chalmers-vera-team/vera-vesc-starter/HW/vera_vesc_starter.kicad_pcb

## KiCad design HW/vera_vesc_starter.kicad_pcb (2026-11-11)

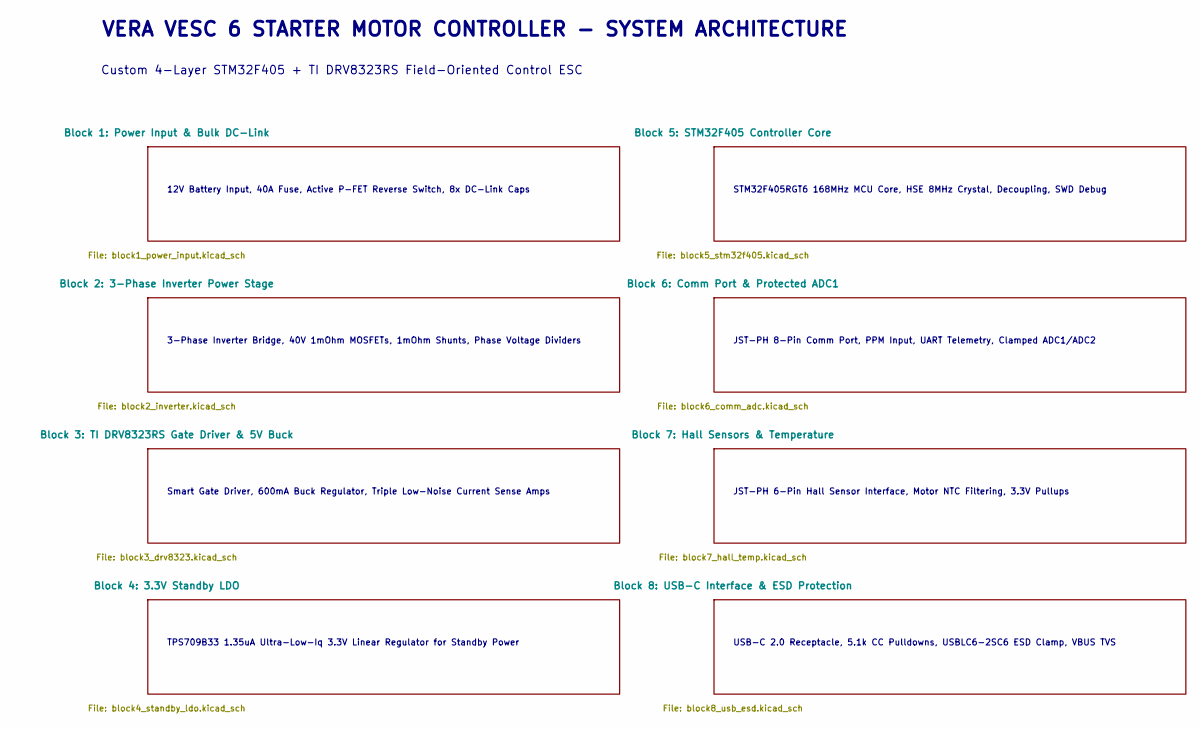
[picture p2: schematic vera_vesc_starter.kicad_sch, Vera VESC 6 Starter Motor Controller]

Notes on the sheet:
Smart Gate Driver, 600mA Buck Regulator, Triple Low-Noise Current Sense Amps
TPS709B33 1.35uA Ultra-Low-Iq 3.3V Linear Regulator for Standby Power
USB-C 2.0 Receptacle, 5.1k CC Pulldowns, USBLC6-2SC6 ESD Clamp, VBUS TVS
STM32F405RGT6 168MHz MCU Core, HSE 8MHz Crystal, Decoupling, SWD Debug
Custom 4-Layer STM32F405 + TI DRV8323RS Field-Oriented Control ESC
3-Phase Inverter Bridge, 40V 1mOhm MOSFETs, 1mOhm Shunts, Phase Voltage Dividers
VERA VESC 6 STARTER MOTOR CONTROLLER - SYSTEM ARCHITECTURE
JST-PH 8-Pin Comm Port, PPM Input, UART Telemetry, Clamped ADC1/ADC2
12V Battery Input, 40A Fuse, Active P-FET Reverse Switch, 8x DC-Link Caps
JST-PH 6-Pin Hall Sensor Interface, Motor NTC Filtering, 3.3V Pullups

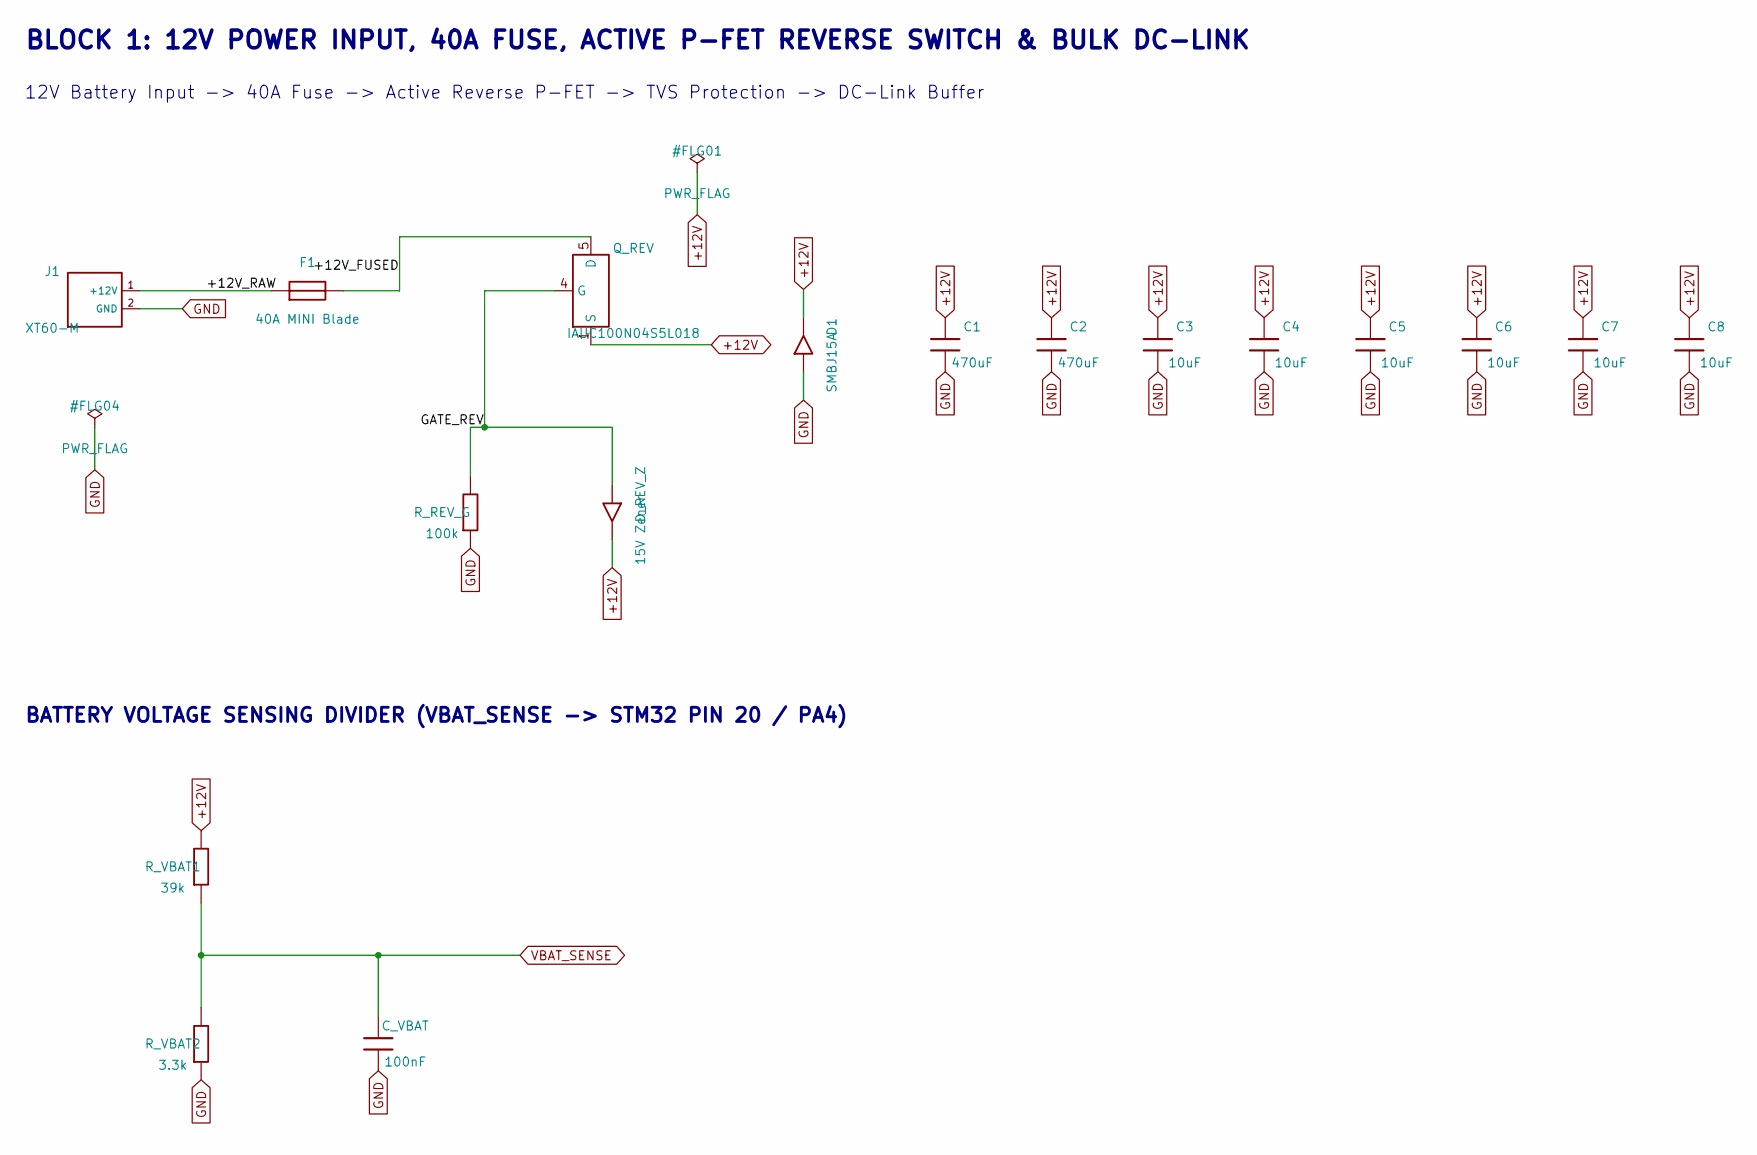
[picture p3: schematic block1_power_input.kicad_sch, Block 1: 12V Power Input & Bulk DC-Link]

Parts:
C1, C2: 470uF; CP_Elec_10x10.5; MPN EEH-ZK1V471P
C3, C4, C5, C6, C7, C8: 10uF; C_1206_3216Metric; MPN C1206C106K5RAC7800
C_VBAT: 100nF; C_0603_1608Metric; MPN CC0603KRX7R9BB104
D1: SMBJ15A; D_SMB; MPN SMBJ15A-E3/52
D_REV_Z: 15V Zener; D_SOD-123; MPN MMSZ5245B
F1: 40A MINI Blade; Fuseholder_Blade_Mini_Keystone_3568; MPN Keystone 3568
J1: XT60-M; AMASS_XT60-M_1x02_P7.20mm_Vertical; MPN AMASS-XT60-M
Q_REV: IAUC100N04S5L018; Infineon_PG-TDSON-8_6.15x5.15mm; MPN IAUC100N04S5L018
R_REV_G: 100k; R_0603_1608Metric; MPN RC0603FR-07100KL
R_VBAT1: 39k; R_0603_1608Metric; MPN RC0603FR-0739KL
R_VBAT2: 3.3k; R_0603_1608Metric; MPN RC0603FR-073K3L

Connections:
+12V: C1.1, C2.1, C3.1, C4.1, C5.1, C6.1, C7.1, C8.1, D1.2 (K), D_REV_Z.2 (K), Q_REV.1 (S), Q_REV.2, Q_REV.3, R_VBAT1.1; also elsewhere on the board
+12V_FUSED: F1.2, Q_REV.5 (D)
+12V_RAW: F1.1, J1.1 (+12V)
GATE_REV: D_REV_Z.1 (A), Q_REV.4 (G), R_REV_G.1
GND: C1.2, C2.2, C3.2, C4.2, C5.2, C6.2, C7.2, C8.2, C_VBAT.2, D1.1 (A), J1.2 (GND), R_REV_G.2, R_VBAT2.2; also elsewhere on the board
VBAT_SENSE: C_VBAT.1, R_VBAT1.2, R_VBAT2.1; also elsewhere on the board

Notes on the sheet:
12V Battery Input -> 40A Fuse -> Active Reverse P-FET -> TVS Protection -> DC-Link Buffer
BATTERY VOLTAGE SENSING DIVIDER (VBAT_SENSE -> STM32 PIN 20 / PA4)
BLOCK 1: 12V POWER INPUT, 40A FUSE, ACTIVE P-FET REVERSE SWITCH & BULK DC-LINK

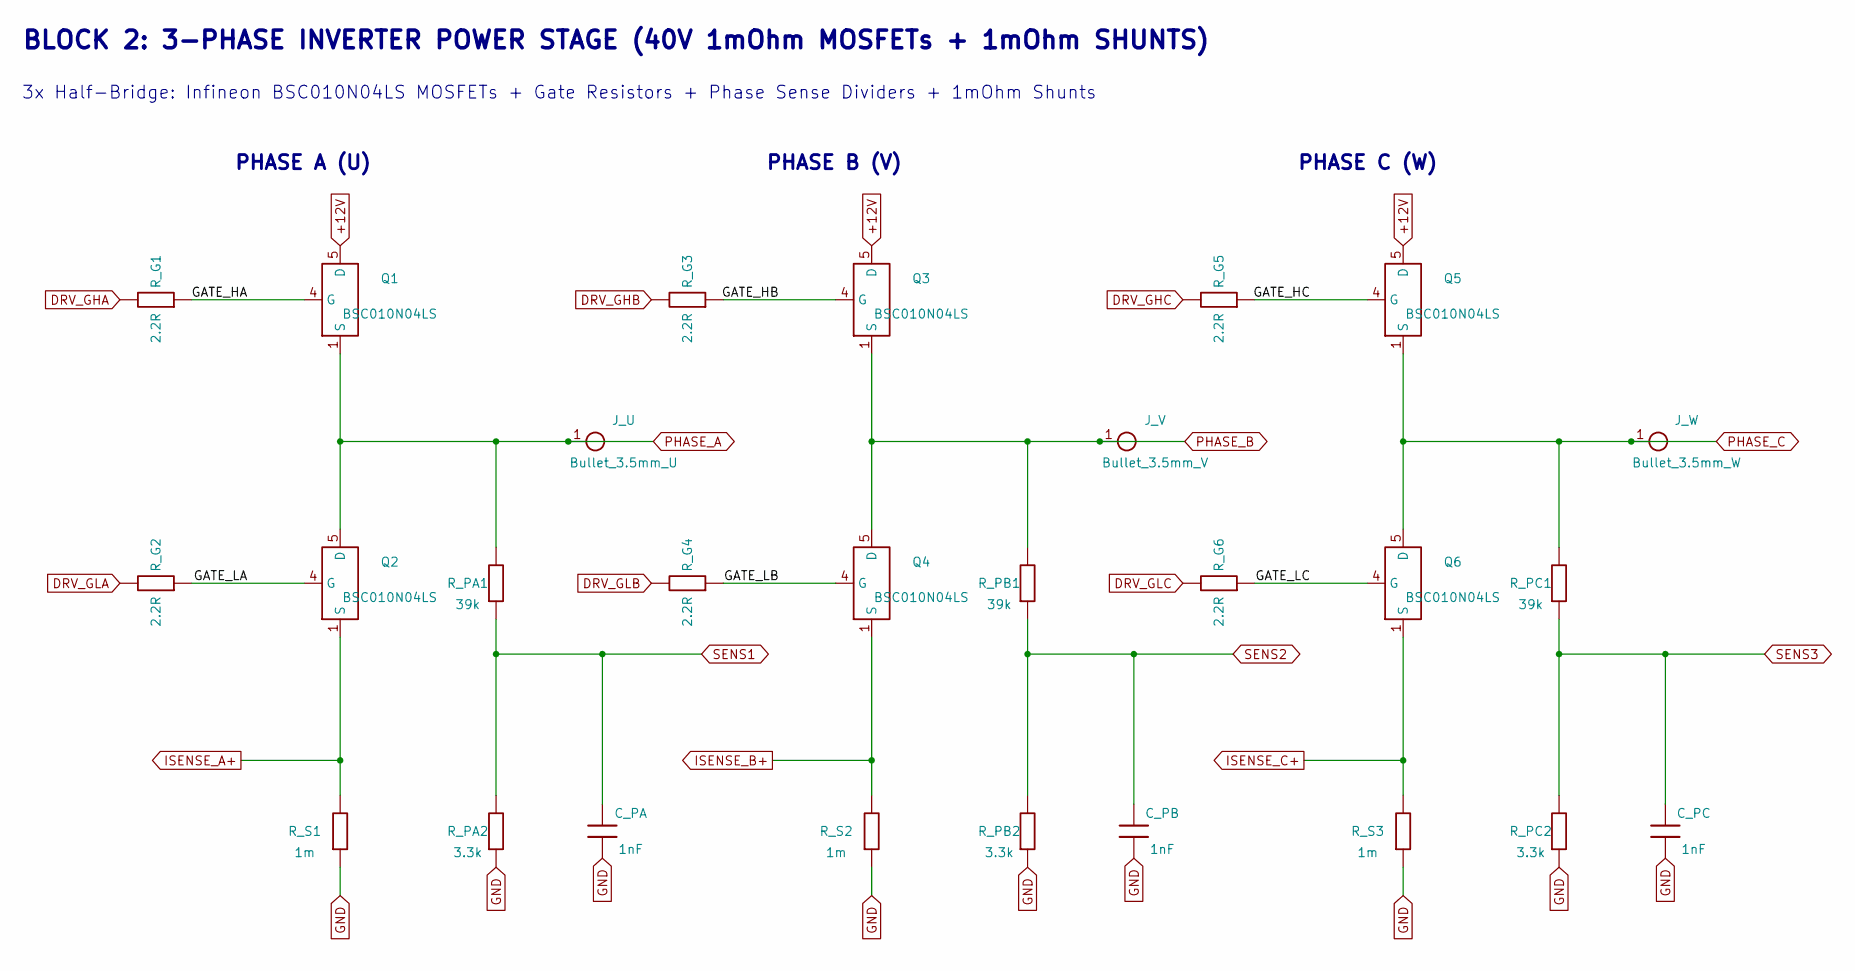
[picture p4: schematic block2_inverter.kicad_sch, Block 2: 3-Phase Inverter Power Stage]

Parts:
C_PA: 1nF; C_0603_1608Metric; MPN CC0603KRX7R9BB102
C_PB: 1nF; C_0603_1608Metric; MPN CC0603KRX7R9BB102
C_PC: 1nF; C_0603_1608Metric; MPN CC0603KRX7R9BB102
J_U: Bullet_3.5mm_U; SolderWire-2.5sqmm_1x01_D2.4mm_OD4.4mm; MPN BULLET-3.5MM-F
J_V: Bullet_3.5mm_V; SolderWire-2.5sqmm_1x01_D2.4mm_OD4.4mm; MPN BULLET-3.5MM-F
J_W: Bullet_3.5mm_W; SolderWire-2.5sqmm_1x01_D2.4mm_OD4.4mm; MPN BULLET-3.5MM-F
Q1, Q2, Q3, Q4, Q5, Q6: BSC010N04LS; Infineon_PG-TDSON-8_6.15x5.15mm; MPN BSC010N04LSATMA1
R_G1, R_G2, R_G3, R_G4, R_G5, R_G6: 2.2R; R_0603_1608Metric; MPN RC0603FR-072R2L
R_PA1: 39k; R_0603_1608Metric; MPN RC0603FR-0739KL
R_PA2: 3.3k; R_0603_1608Metric; MPN RC0603FR-073K3L
R_PB1: 39k; R_0603_1608Metric; MPN RC0603FR-0739KL
R_PB2: 3.3k; R_0603_1608Metric; MPN RC0603FR-073K3L
R_PC1: 39k; R_0603_1608Metric; MPN RC0603FR-0739KL
R_PC2: 3.3k; R_0603_1608Metric; MPN RC0603FR-073K3L
R_S1, R_S2, R_S3: 1m; R_2512_6332Metric; MPN WSLP25121L000FEA

Connections:
+12V: Q1.5 (D), Q3.5 (D), Q5.5 (D); also elsewhere on the board
DRV_GHA: R_G1.1; also elsewhere on the board
DRV_GHB: R_G3.1; also elsewhere on the board
DRV_GHC: R_G5.1; also elsewhere on the board
DRV_GLA: R_G2.1; also elsewhere on the board
DRV_GLB: R_G4.1; also elsewhere on the board
DRV_GLC: R_G6.1; also elsewhere on the board
GATE_HA: Q1.4 (G), R_G1.2
GATE_HB: Q3.4 (G), R_G3.2
GATE_HC: Q5.4 (G), R_G5.2
GATE_LA: Q2.4 (G), R_G2.2
GATE_LB: Q4.4 (G), R_G4.2
GATE_LC: Q6.4 (G), R_G6.2
GND: C_PA.2, C_PB.2, C_PC.2, R_PA2.2, R_PB2.2, R_PC2.2, R_S1.2, R_S2.2, R_S3.2; also elsewhere on the board
ISENSE_A+: Q2.1 (S), Q2.2, Q2.3, R_S1.1; also elsewhere on the board
ISENSE_B+: Q4.1 (S), Q4.2, Q4.3, R_S2.1; also elsewhere on the board
ISENSE_C+: Q6.1 (S), Q6.2, Q6.3, R_S3.1; also elsewhere on the board
PHASE_A: J_U.1, Q1.1 (S), Q1.2, Q1.3, Q2.5 (D), R_PA1.1; also elsewhere on the board
PHASE_B: J_V.1, Q3.1 (S), Q3.2, Q3.3, Q4.5 (D), R_PB1.1; also elsewhere on the board
PHASE_C: J_W.1, Q5.1 (S), Q5.2, Q5.3, Q6.5 (D), R_PC1.1; also elsewhere on the board
SENS1: C_PA.1, R_PA1.2, R_PA2.1; also elsewhere on the board
SENS2: C_PB.1, R_PB1.2, R_PB2.1; also elsewhere on the board
SENS3: C_PC.1, R_PC1.2, R_PC2.1; also elsewhere on the board

Notes on the sheet:
BLOCK 2: 3-PHASE INVERTER POWER STAGE (40V 1mOhm MOSFETs + 1mOhm SHUNTS)
PHASE B (V)
PHASE C (W)
PHASE A (U)
3x Half-Bridge: Infineon BSC010N04LS MOSFETs + Gate Resistors + Phase Sense Dividers + 1mOhm Shunts

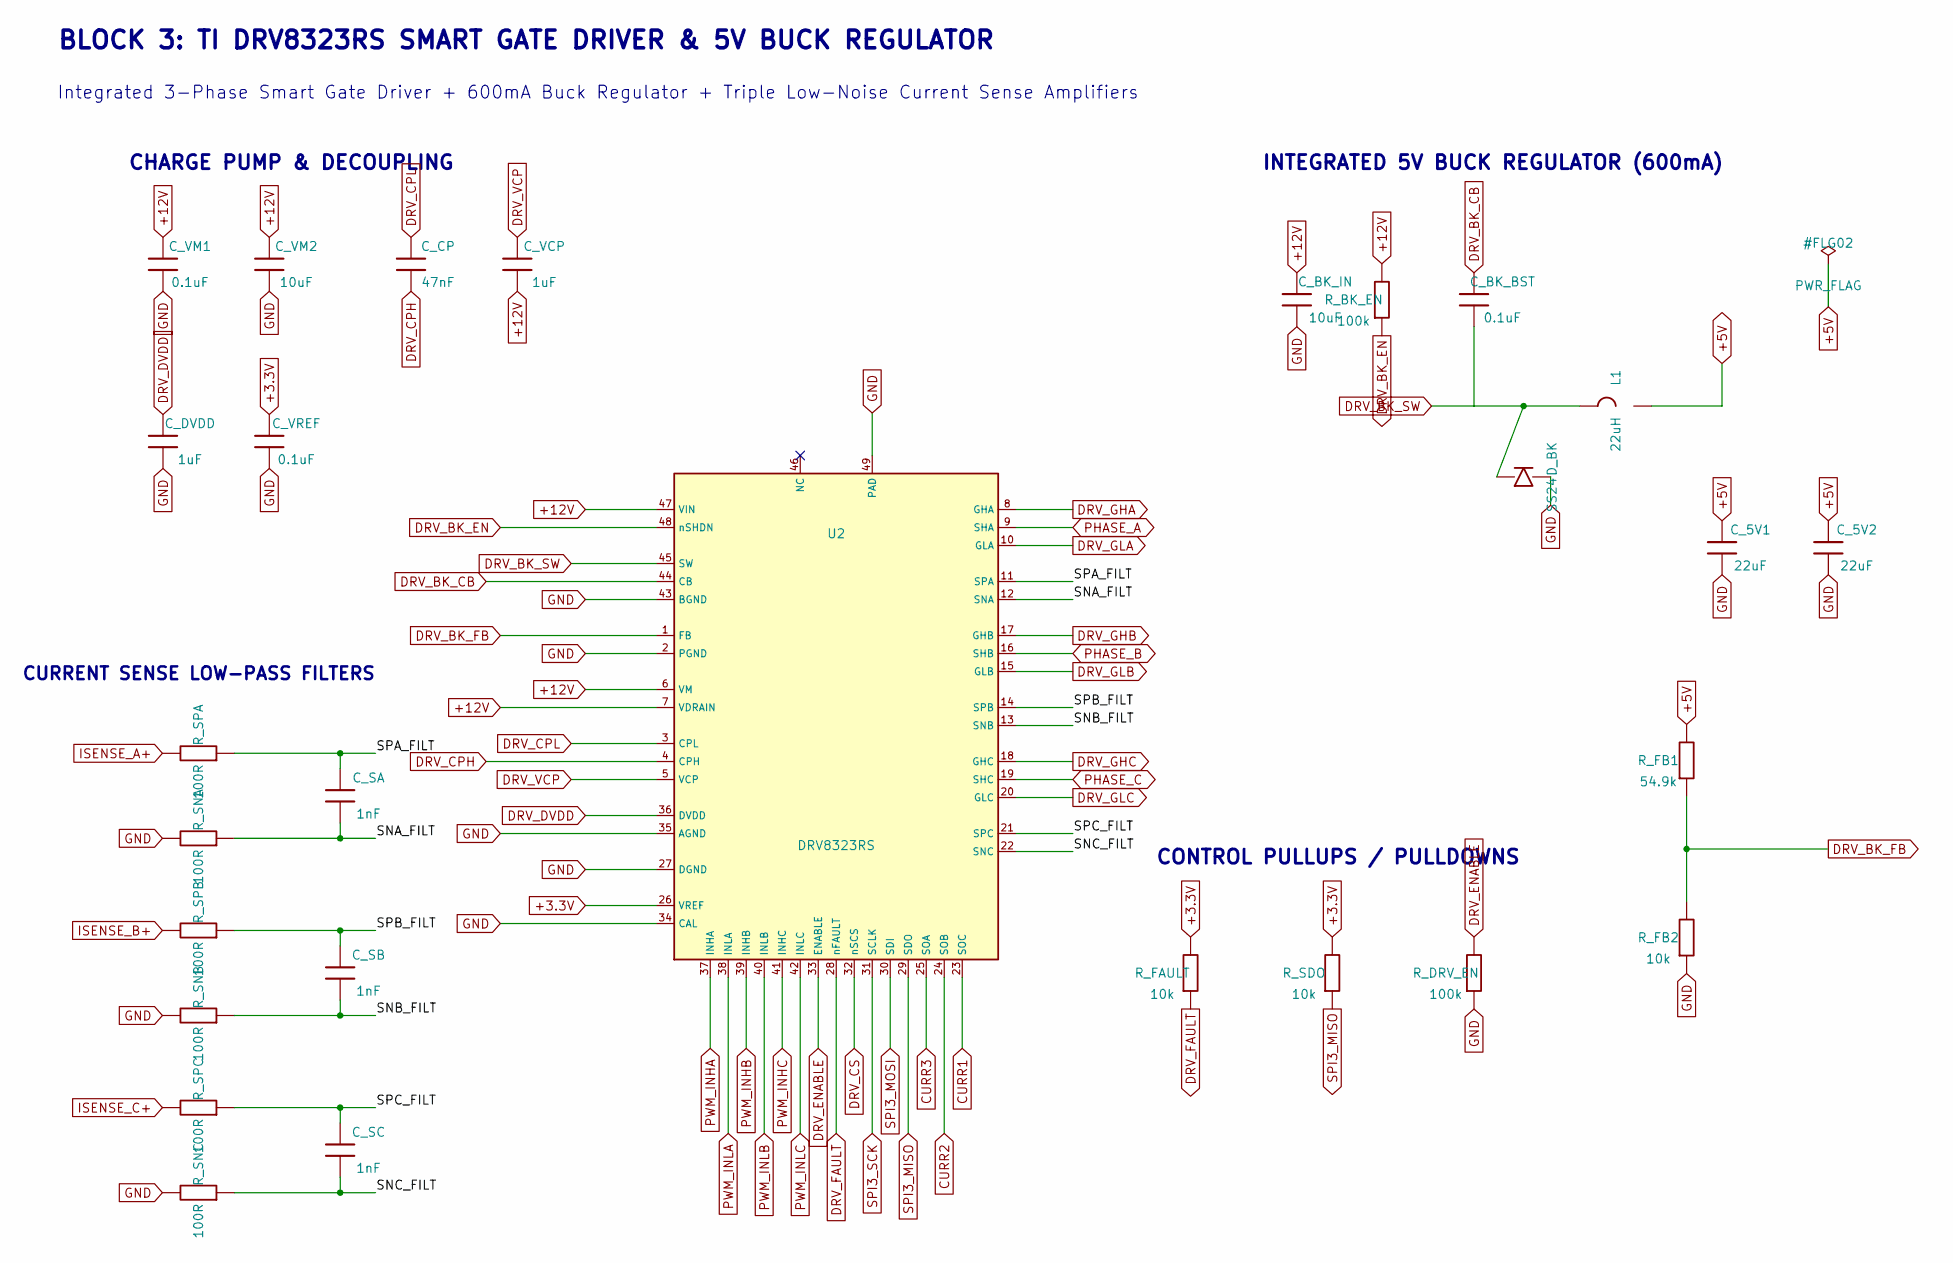
[picture p5: schematic block3_drv8323.kicad_sch, Block 3: TI DRV8323RS Gate Driver & 5V Buck]

Parts:
C_5V1, C_5V2: 22uF; C_0805_2012Metric; MPN CL21A226KOQNNNE
C_BK_BST: 0.1uF; C_0603_1608Metric; MPN CC0603KRX7R8BB104
C_BK_IN: 10uF; C_0805_2012Metric; MPN CL21A106KAYNNNE
C_CP: 47nF; C_0603_1608Metric; MPN CC0603KRX7R9BB473
C_DVDD: 1uF; C_0603_1608Metric; MPN CC0603KRX7R7BB105
C_SA: 1nF; C_0603_1608Metric; MPN CC0603KRX7R9BB102
C_SB: 1nF; C_0603_1608Metric; MPN CC0603KRX7R9BB102
C_SC: 1nF; C_0603_1608Metric; MPN CC0603KRX7R9BB102
C_VCP: 1uF; C_0603_1608Metric; MPN CC0603KRX7R7BB105
C_VM1: 0.1uF; C_0603_1608Metric; MPN CC0603KRX7R9BB104
C_VM2: 10uF; C_1206_3216Metric; MPN C1206C106K5RAC7800
C_VREF: 0.1uF; C_0603_1608Metric; MPN CC0603KRX7R8BB104
D_BK: SS24; D_SMA; MPN SS24
L1: 22uH; L_7.3x7.3_H4.5; MPN SRR7045-220M
R_BK_EN: 100k; R_0603_1608Metric; MPN RC0603FR-07100KL
R_DRV_EN: 100k; R_0603_1608Metric; MPN RC0603FR-07100KL
R_FAULT: 10k; R_0603_1608Metric; MPN RC0603FR-0710KL
R_FB1: 54.9k; R_0603_1608Metric; MPN RC0603FR-0754K9L
R_FB2: 10k; R_0603_1608Metric; MPN RC0603FR-0710KL
R_SDO: 10k; R_0603_1608Metric; MPN RC0603FR-0710KL
R_SNA: 100R; R_0603_1608Metric; MPN RC0603FR-07100RL
R_SNB: 100R; R_0603_1608Metric; MPN RC0603FR-07100RL
R_SNC: 100R; R_0603_1608Metric; MPN RC0603FR-07100RL
R_SPA: 100R; R_0603_1608Metric; MPN RC0603FR-07100RL
R_SPB: 100R; R_0603_1608Metric; MPN RC0603FR-07100RL
R_SPC: 100R; R_0603_1608Metric; MPN RC0603FR-07100RL
U2: DRV8323RS; QFN-48-1EP_7x7mm_P0.5mm_EP5.15x5.15mm; MPN DRV8323RSRGZT

Connections:
+3.3V: C_VREF.1, R_FAULT.1, R_SDO.1, U2.26 (VREF); also elsewhere on the board
+5V: C_5V1.1, C_5V2.1, L1.2, R_FB1.1; also elsewhere on the board
+12V: C_BK_IN.1, C_VCP.2, C_VM1.1, C_VM2.1, R_BK_EN.1, U2.6 (VM), U2.7 (VDRAIN), U2.47 (VIN); also elsewhere on the board
CURR1: U2.23 (SOC); also elsewhere on the board
CURR2: U2.24 (SOB); also elsewhere on the board
CURR3: U2.25 (SOA); also elsewhere on the board
DRV_BK_CB: C_BK_BST.2, U2.44 (CB)
DRV_BK_EN: R_BK_EN.2, U2.48 (nSHDN)
DRV_BK_FB: R_FB1.2, R_FB2.1, U2.1 (FB)
DRV_BK_SW: C_BK_BST.1, D_BK.1 (K), L1.1, U2.45 (SW)
DRV_CPH: C_CP.2, U2.4 (CPH)
DRV_CPL: C_CP.1, U2.3 (CPL)
DRV_CS: U2.32 (nSCS); also elsewhere on the board
DRV_DVDD: C_DVDD.1, U2.36 (DVDD)
DRV_ENABLE: R_DRV_EN.1, U2.33 (ENABLE); also elsewhere on the board
DRV_FAULT: R_FAULT.2, U2.28 (nFAULT); also elsewhere on the board
DRV_GHA: U2.8 (GHA); also elsewhere on the board
DRV_GHB: U2.17 (GHB); also elsewhere on the board
DRV_GHC: U2.18 (GHC); also elsewhere on the board
DRV_GLA: U2.10 (GLA); also elsewhere on the board
DRV_GLB: U2.15 (GLB); also elsewhere on the board
DRV_GLC: U2.20 (GLC); also elsewhere on the board
DRV_VCP: C_VCP.1, U2.5 (VCP)
GND: C_5V1.2, C_5V2.2, C_BK_IN.2, C_DVDD.2, C_VM1.2, C_VM2.2, C_VREF.2, D_BK.2 (A), R_DRV_EN.2, R_FB2.2, R_SNA.1, R_SNB.1, R_SNC.1, U2.2 (PGND), U2.27 (DGND), U2.34 (CAL), U2.35 (AGND), U2.43 (BGND), U2.49 (PAD); also elsewhere on the board
ISENSE_A+: R_SPA.1; also elsewhere on the board
ISENSE_B+: R_SPB.1; also elsewhere on the board
ISENSE_C+: R_SPC.1; also elsewhere on the board
PHASE_A: U2.9 (SHA); also elsewhere on the board
PHASE_B: U2.16 (SHB); also elsewhere on the board
PHASE_C: U2.19 (SHC); also elsewhere on the board
PWM_INHA: U2.37 (INHA); also elsewhere on the board
PWM_INHB: U2.39 (INHB); also elsewhere on the board
PWM_INHC: U2.41 (INHC); also elsewhere on the board
PWM_INLA: U2.38 (INLA); also elsewhere on the board
PWM_INLB: U2.40 (INLB); also elsewhere on the board
PWM_INLC: U2.42 (INLC); also elsewhere on the board
SNA_FILT: C_SA.2, R_SNA.2, U2.12 (SNA)
SNB_FILT: C_SB.2, R_SNB.2, U2.13 (SNB)
SNC_FILT: C_SC.2, R_SNC.2, U2.22 (SNC)
SPA_FILT: C_SA.1, R_SPA.2, U2.11 (SPA)
SPB_FILT: C_SB.1, R_SPB.2, U2.14 (SPB)
SPC_FILT: C_SC.1, R_SPC.2, U2.21 (SPC)
SPI3_MISO: R_SDO.2, U2.29 (SDO); also elsewhere on the board
SPI3_MOSI: U2.30 (SDI); also elsewhere on the board
SPI3_SCK: U2.31 (SCLK); also elsewhere on the board

Notes on the sheet:
INTEGRATED 5V BUCK REGULATOR (600mA)
CURRENT SENSE LOW-PASS FILTERS
Integrated 3-Phase Smart Gate Driver + 600mA Buck Regulator + Triple Low-Noise Current Sense Amplifiers
CHARGE PUMP & DECOUPLING
BLOCK 3: TI DRV8323RS SMART GATE DRIVER & 5V BUCK REGULATOR
CONTROL PULLUPS / PULLDOWNS

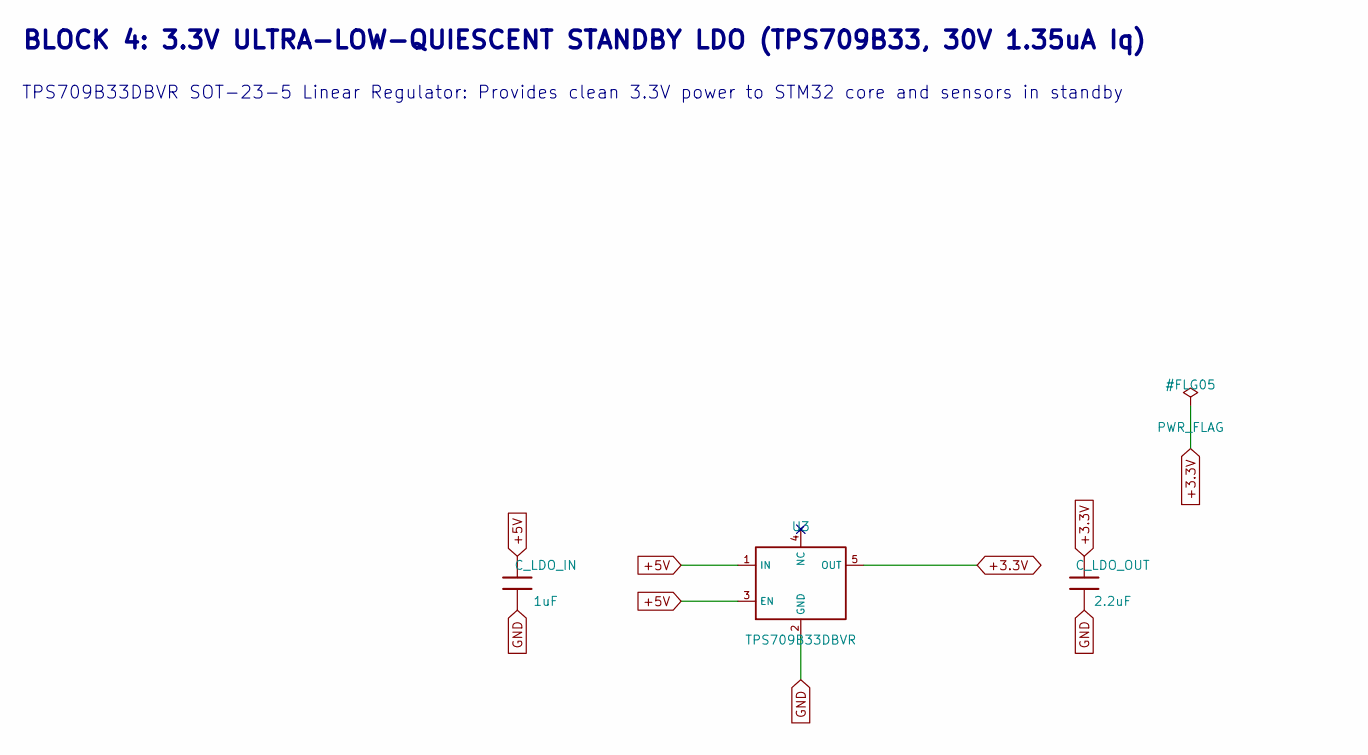
[picture p6: schematic block4_standby_ldo.kicad_sch, Block 4: 3.3V Standby LDO]

Parts:
C_LDO_IN: 1uF; C_0603_1608Metric; MPN CC0603KRX7R8BB105
C_LDO_OUT: 2.2uF; C_0603_1608Metric; MPN CC0603KRX7R6BB225
U3: TPS709B33DBVR; SOT-23-5; MPN TPS709B33DBVR

Connections:
+3.3V: C_LDO_OUT.1, U3.5 (OUT); also elsewhere on the board
+5V: C_LDO_IN.1, U3.1 (IN), U3.3 (EN); also elsewhere on the board
GND: C_LDO_IN.2, C_LDO_OUT.2, U3.2 (GND); also elsewhere on the board

Notes on the sheet:
BLOCK 4: 3.3V ULTRA-LOW-QUIESCENT STANDBY LDO (TPS709B33, 30V 1.35uA Iq)
TPS709B33DBVR SOT-23-5 Linear Regulator: Provides clean 3.3V power to STM32 core and sensors in standby

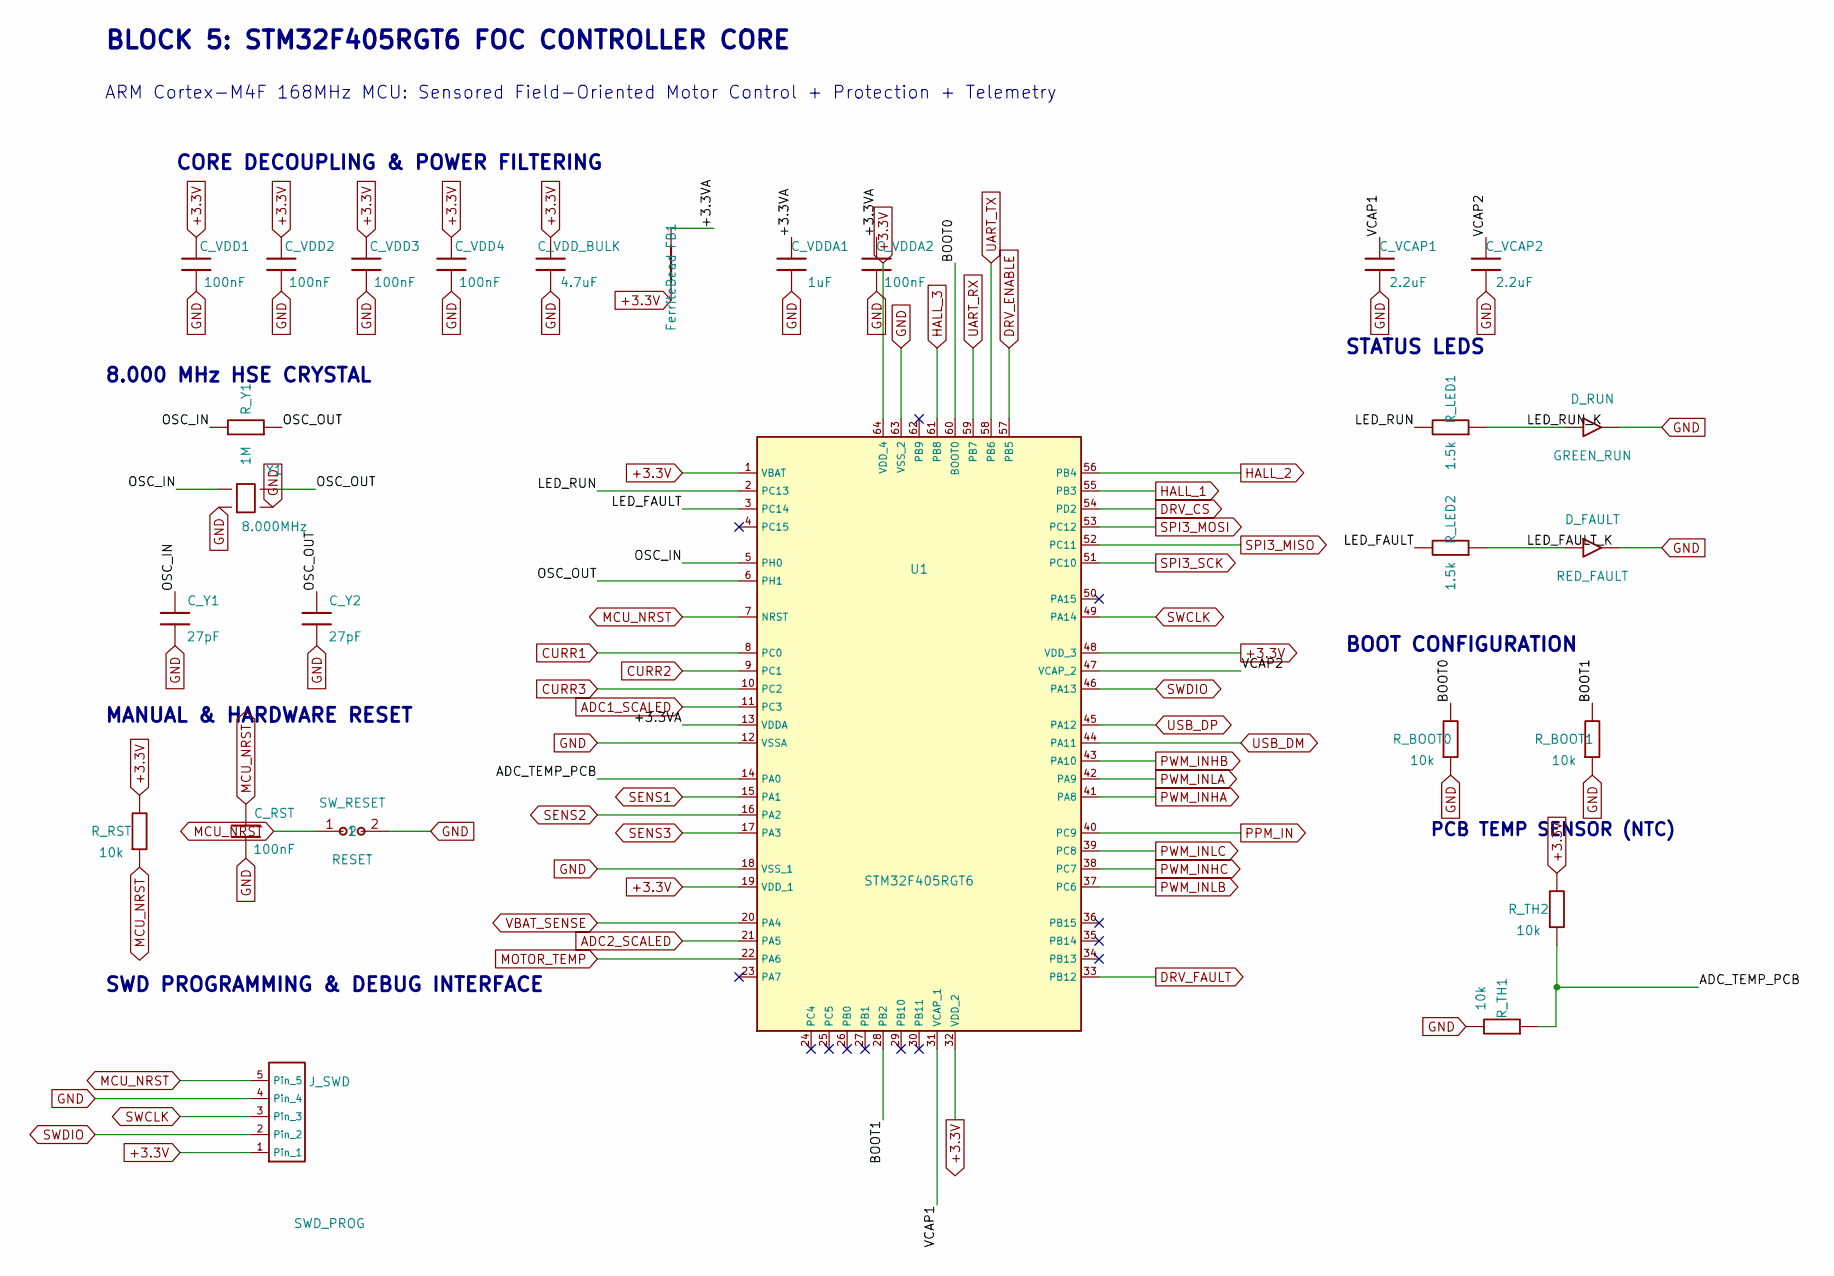
[picture p7: schematic block5_stm32f405.kicad_sch, Block 5: STM32F405 Controller Core]

Parts:
C_RST: 100nF; C_0603_1608Metric; MPN CC0603KRX7R9BB104
C_VCAP1, C_VCAP2: 2.2uF; C_0603_1608Metric; MPN CC0603KRX7R6BB225
C_VDD1, C_VDD2, C_VDD3, C_VDD4: 100nF; C_0603_1608Metric; MPN CC0603KRX7R9BB104
C_VDDA1: 1uF; C_0603_1608Metric; MPN CC0603KRX7R7BB105
C_VDDA2: 100nF; C_0603_1608Metric; MPN CC0603KRX7R9BB104
C_VDD_BULK: 4.7uF; C_0805_2012Metric; MPN CL21A475KOQNNNE
C_Y1, C_Y2: 27pF; C_0603_1608Metric; MPN CC0603JRNPO9BN270
D_FAULT: RED_FAULT; LED_0603_1608Metric; MPN LTST-C190KRKT
D_RUN: GREEN_RUN; LED_0603_1608Metric; MPN LTST-C190GKT
FB1: FerriteBead; L_0805_2012Metric; MPN BLM21PG221SN1D
J_SWD: SWD_PROG; PinHeader_1x05_P2.54mm_Vertical; MPN M20-9990546
R_BOOT0, R_BOOT1: 10k; R_0603_1608Metric; MPN RC0603FR-0710KL
R_LED1, R_LED2: 1.5k; R_0603_1608Metric; MPN RC0603FR-071K5L
R_RST: 10k; R_0603_1608Metric; MPN RC0603FR-0710KL
R_TH1: 10k; R_0603_1608Metric; MPN NCP18XH103F03RB
R_TH2: 10k; R_0603_1608Metric; MPN RC0603FR-0710KL
R_Y1: 1M; R_0603_1608Metric; MPN RC0603FR-071ML
SW_RESET: RESET; SW_SPST_PTS645Sx43SMTR92; MPN PTS645SL43-2 LFS
U1: STM32F405RGT6; LQFP-64_10x10mm_P0.5mm; MPN STM32F405RGT6
Y1: 8.000MHz; Crystal_SMD_3225-4Pin_3.2x2.5mm; MPN ABM8-8.000MHZ-B2-T

Connections:
+3.3V: C_VDD1.1, C_VDD2.1, C_VDD3.1, C_VDD4.1, C_VDD_BULK.1, FB1.1, J_SWD.1, R_RST.1, R_TH2.1, U1.1 (VBAT), U1.19 (VDD_1), U1.32 (VDD_2), U1.48 (VDD_3), U1.64 (VDD_4); also elsewhere on the board
+3.3VA: C_VDDA1.1, C_VDDA2.1, FB1.2, U1.13 (VDDA)
ADC1_SCALED: U1.11 (PC3); also elsewhere on the board
ADC2_SCALED: U1.21 (PA5); also elsewhere on the board
ADC_TEMP_PCB: R_TH1.2, R_TH2.2, U1.14 (PA0)
BOOT0: R_BOOT0.1, U1.60 (BOOT0)
BOOT1: R_BOOT1.1, U1.28 (PB2)
CURR1: U1.8 (PC0); also elsewhere on the board
CURR2: U1.9 (PC1); also elsewhere on the board
CURR3: U1.10 (PC2); also elsewhere on the board
DRV_CS: U1.54 (PD2); also elsewhere on the board
DRV_ENABLE: U1.57 (PB5); also elsewhere on the board
DRV_FAULT: U1.33 (PB12); also elsewhere on the board
GND: C_RST.2, C_VCAP1.2, C_VCAP2.2, C_VDD1.2, C_VDD2.2, C_VDD3.2, C_VDD4.2, C_VDDA1.2, C_VDDA2.2, C_VDD_BULK.2, C_Y1.2, C_Y2.2, D_FAULT.2 (K), D_RUN.2 (K), J_SWD.4, R_BOOT0.2, R_BOOT1.2, R_TH1.1, SW_RESET.2, U1.12 (VSSA), U1.18 (VSS_1), U1.63 (VSS_2), Y1.2, Y1.4; also elsewhere on the board
HALL_1: U1.55 (PB3); also elsewhere on the board
HALL_2: U1.56 (PB4); also elsewhere on the board
HALL_3: U1.61 (PB8); also elsewhere on the board
LED_FAULT: R_LED2.1, U1.3 (PC14)
LED_FAULT_K: D_FAULT.1 (A), R_LED2.2
LED_RUN: R_LED1.1, U1.2 (PC13)
LED_RUN_K: D_RUN.1 (A), R_LED1.2
MCU_NRST: C_RST.1, J_SWD.5, R_RST.2, SW_RESET.1, U1.7 (NRST)
MOTOR_TEMP: U1.22 (PA6); also elsewhere on the board
OSC_IN: C_Y1.1, R_Y1.1, U1.5 (PH0), Y1.1
OSC_OUT: C_Y2.1, R_Y1.2, U1.6 (PH1), Y1.3
PPM_IN: U1.40 (PC9); also elsewhere on the board
PWM_INHA: U1.41 (PA8); also elsewhere on the board
PWM_INHB: U1.43 (PA10); also elsewhere on the board
PWM_INHC: U1.38 (PC7); also elsewhere on the board
PWM_INLA: U1.42 (PA9); also elsewhere on the board
PWM_INLB: U1.37 (PC6); also elsewhere on the board
PWM_INLC: U1.39 (PC8); also elsewhere on the board
SENS1: U1.15 (PA1); also elsewhere on the board
SENS2: U1.16 (PA2); also elsewhere on the board
SENS3: U1.17 (PA3); also elsewhere on the board
SPI3_MISO: U1.52 (PC11); also elsewhere on the board
SPI3_MOSI: U1.53 (PC12); also elsewhere on the board
SPI3_SCK: U1.51 (PC10); also elsewhere on the board
SWCLK: J_SWD.3, U1.49 (PA14)
SWDIO: J_SWD.2, U1.46 (PA13)
UART_RX: U1.59 (PB7); also elsewhere on the board
UART_TX: U1.58 (PB6); also elsewhere on the board
USB_DM: U1.44 (PA11); also elsewhere on the board
USB_DP: U1.45 (PA12); also elsewhere on the board
VBAT_SENSE: U1.20 (PA4); also elsewhere on the board
VCAP1: C_VCAP1.1, U1.31 (VCAP_1)
VCAP2: C_VCAP2.1, U1.47 (VCAP_2)

Notes on the sheet:
BLOCK 5: STM32F405RGT6 FOC CONTROLLER CORE
ARM Cortex-M4F 168MHz MCU: Sensored Field-Oriented Motor Control + Protection + Telemetry
CORE DECOUPLING & POWER FILTERING
MANUAL & HARDWARE RESET
PCB TEMP SENSOR (NTC)
BOOT CONFIGURATION
STATUS LEDS
8.000 MHz HSE CRYSTAL
SWD PROGRAMMING & DEBUG INTERFACE

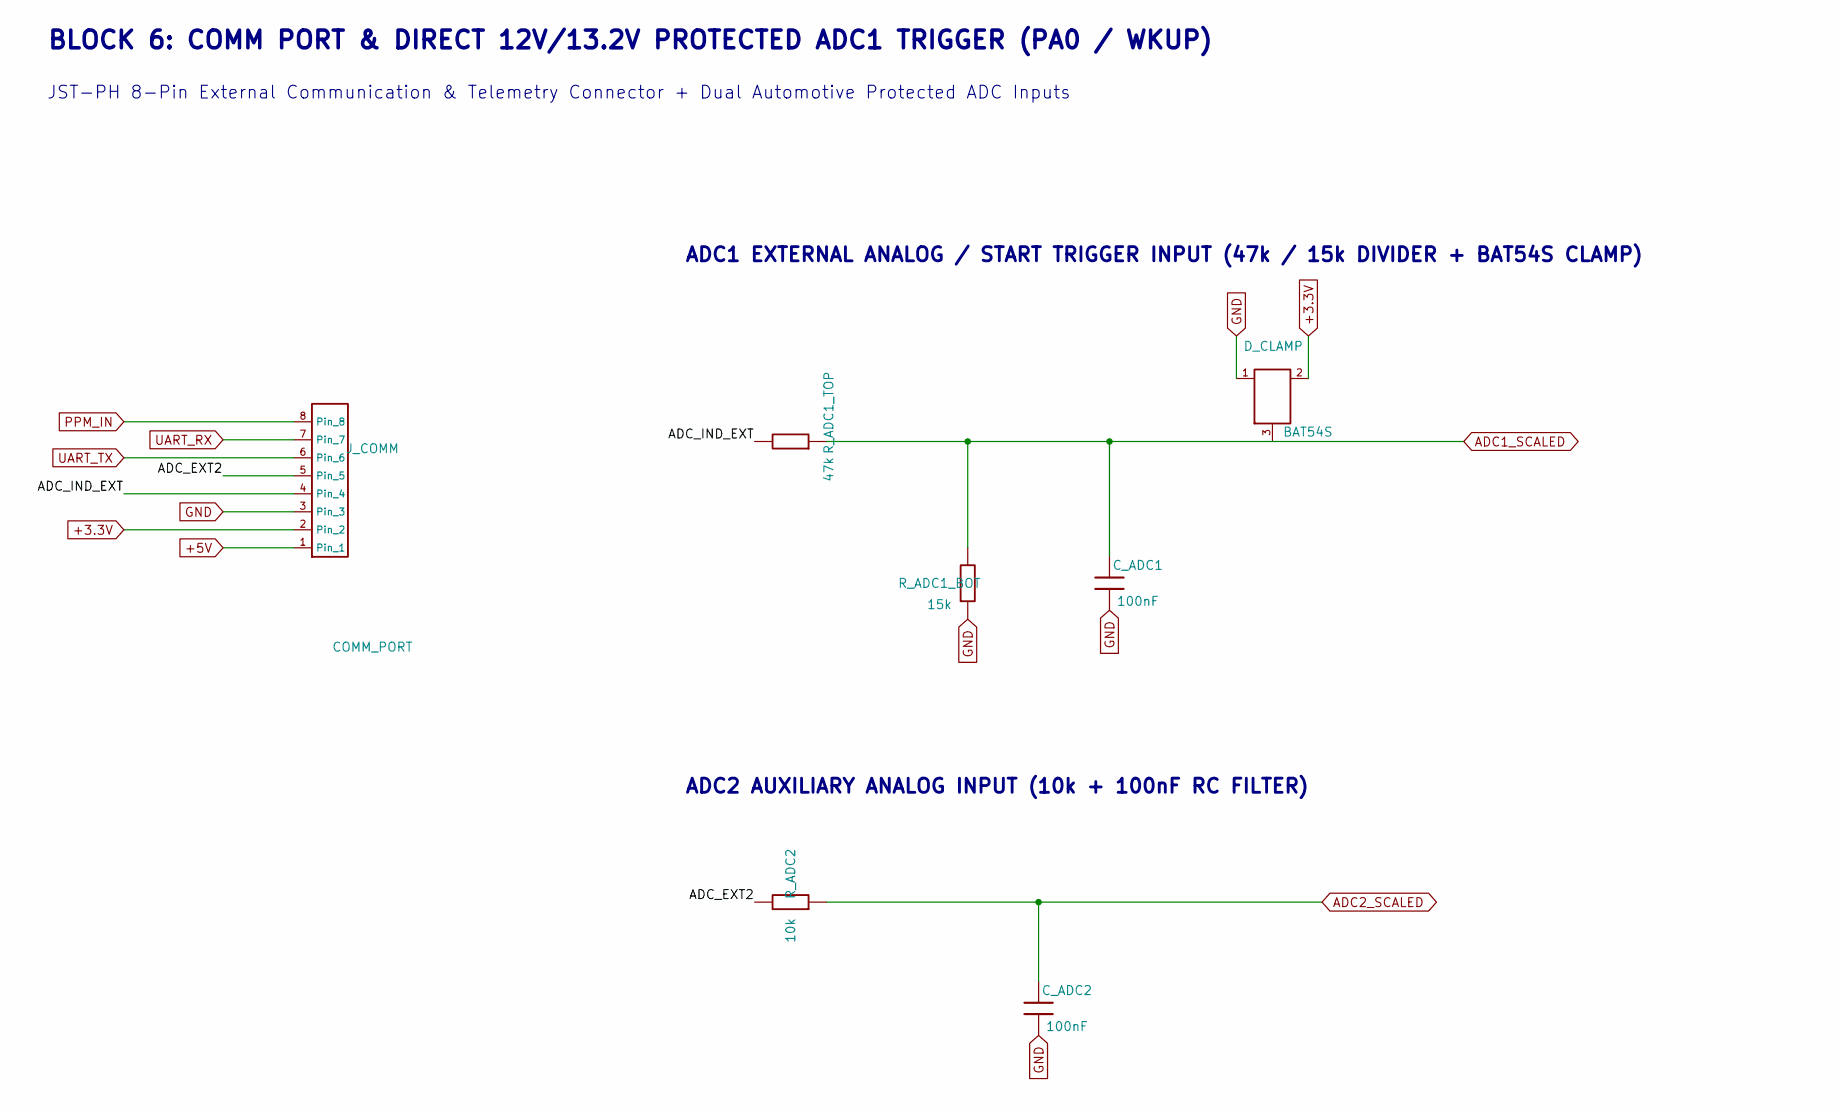
[picture p8: schematic block6_comm_adc.kicad_sch, Block 6: Comm Port & Protected ADC1]

Parts:
C_ADC1, C_ADC2: 100nF; C_0603_1608Metric; MPN CC0603KRX7R9BB104
D_CLAMP: BAT54S; SOT-23; MPN BAT54S-7-F
J_COMM: COMM_PORT; JST_PH_B8B-PH-K_1x08_P2.00mm_Vertical; MPN B8B-PH-K-S
R_ADC1_BOT: 15k; R_0603_1608Metric; MPN RC0603FR-0715KL
R_ADC1_TOP: 47k; R_0603_1608Metric; MPN RC0603FR-0747KL
R_ADC2: 10k; R_0603_1608Metric; MPN RC0603FR-0710KL

Connections:
+3.3V: D_CLAMP.2 (Cathode2), J_COMM.2; also elsewhere on the board
+5V: J_COMM.1; also elsewhere on the board
ADC1_SCALED: C_ADC1.1, D_CLAMP.3 (Cath1_An2), R_ADC1_BOT.1, R_ADC1_TOP.2; also elsewhere on the board
ADC2_SCALED: C_ADC2.1, R_ADC2.2; also elsewhere on the board
ADC_EXT2: J_COMM.5, R_ADC2.1
ADC_IND_EXT: J_COMM.4, R_ADC1_TOP.1
GND: C_ADC1.2, C_ADC2.2, D_CLAMP.1 (Anode1), J_COMM.3, R_ADC1_BOT.2; also elsewhere on the board
PPM_IN: J_COMM.8; also elsewhere on the board
UART_RX: J_COMM.7; also elsewhere on the board
UART_TX: J_COMM.6; also elsewhere on the board

Notes on the sheet:
JST-PH 8-Pin External Communication & Telemetry Connector + Dual Automotive Protected ADC Inputs
ADC1 EXTERNAL ANALOG / START TRIGGER INPUT (47k / 15k DIVIDER + BAT54S CLAMP)
ADC2 AUXILIARY ANALOG INPUT (10k + 100nF RC FILTER)
BLOCK 6: COMM PORT & DIRECT 12V/13.2V PROTECTED ADC1 TRIGGER (PA0 / WKUP)
