chalmers-vera-team/vera-vesc-starter/HW/vera_vesc_starter.kicad_pcb

## KiCad design HW/vera_vesc_starter.kicad_pcb (continued)

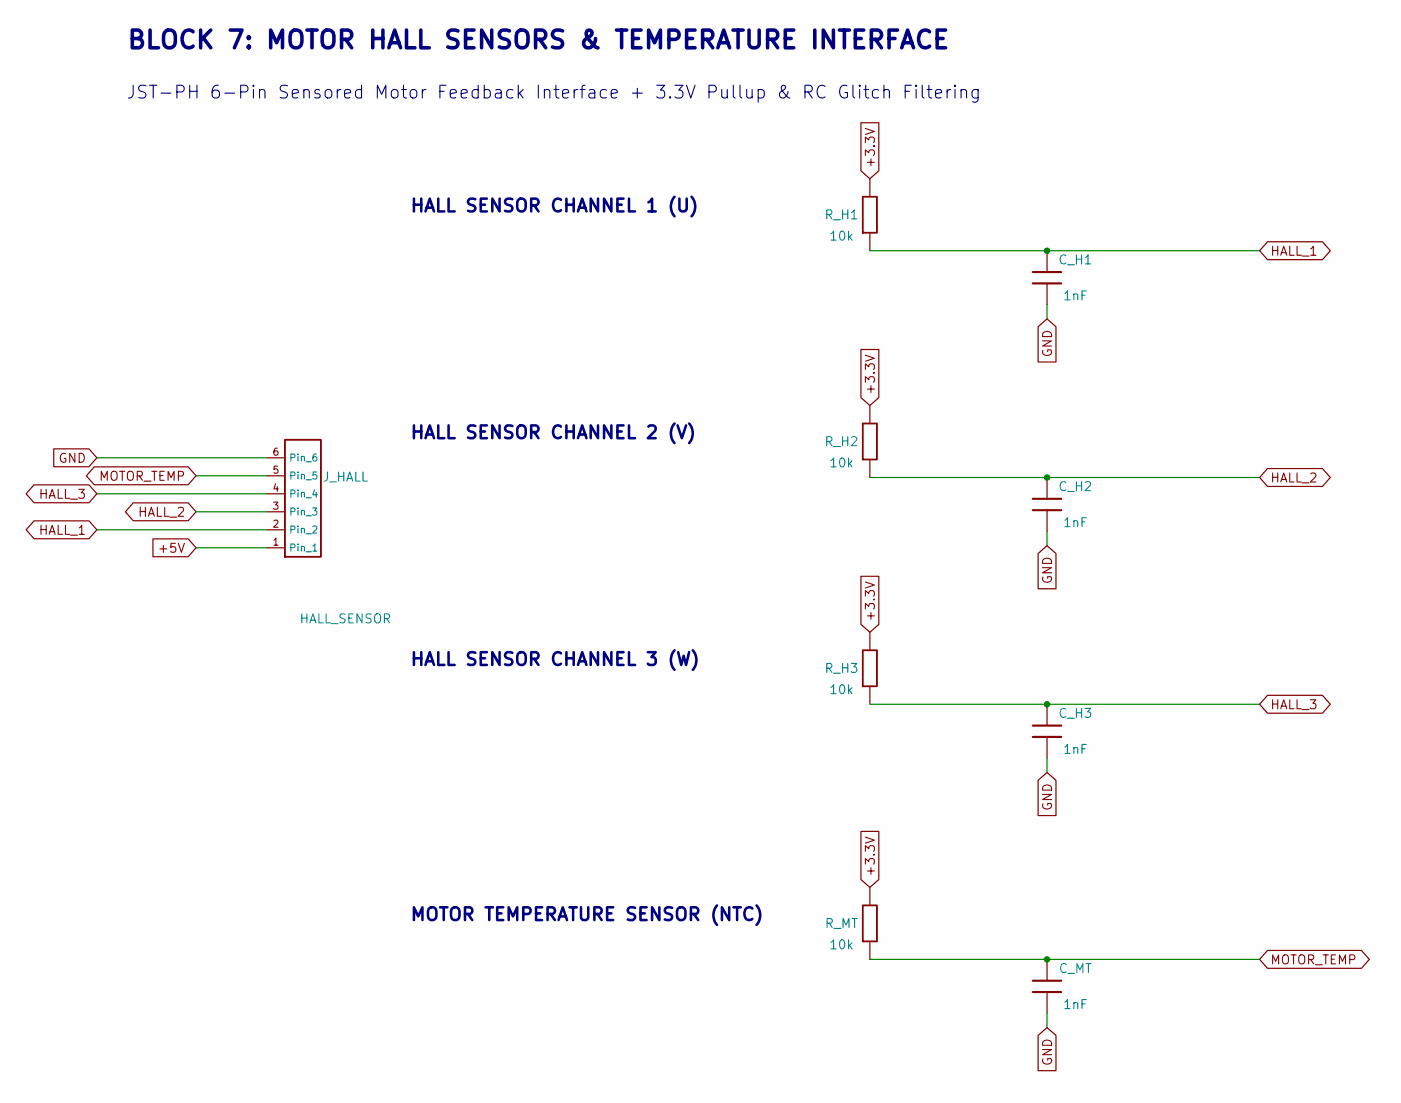
[picture p9: schematic block7_hall_temp.kicad_sch, Block 7: Motor Hall Sensors & Temperature Interface]

Parts:
C_H1, C_H2, C_H3: 1nF; C_0603_1608Metric; MPN CC0603KRX7R9BB102
C_MT: 1nF; C_0603_1608Metric; MPN CC0603KRX7R9BB102
J_HALL: HALL_SENSOR; JST_PH_B6B-PH-K_1x06_P2.00mm_Vertical; MPN B6B-PH-K-S
R_H1, R_H2, R_H3: 10k; R_0603_1608Metric; MPN RC0603FR-0710KL
R_MT: 10k; R_0603_1608Metric; MPN RC0603FR-0710KL

Connections:
+3.3V: R_H1.1, R_H2.1, R_H3.1, R_MT.1; also elsewhere on the board
+5V: J_HALL.1; also elsewhere on the board
GND: C_H1.2, C_H2.2, C_H3.2, C_MT.2, J_HALL.6; also elsewhere on the board
HALL_1: C_H1.1, J_HALL.2, R_H1.2; also elsewhere on the board
HALL_2: C_H2.1, J_HALL.3, R_H2.2; also elsewhere on the board
HALL_3: C_H3.1, J_HALL.4, R_H3.2; also elsewhere on the board
MOTOR_TEMP: C_MT.1, J_HALL.5, R_MT.2; also elsewhere on the board

Notes on the sheet:
HALL SENSOR CHANNEL 2 (V)
HALL SENSOR CHANNEL 3 (W)
BLOCK 7: MOTOR HALL SENSORS & TEMPERATURE INTERFACE
HALL SENSOR CHANNEL 1 (U)
MOTOR TEMPERATURE SENSOR (NTC)
JST-PH 6-Pin Sensored Motor Feedback Interface + 3.3V Pullup & RC Glitch Filtering

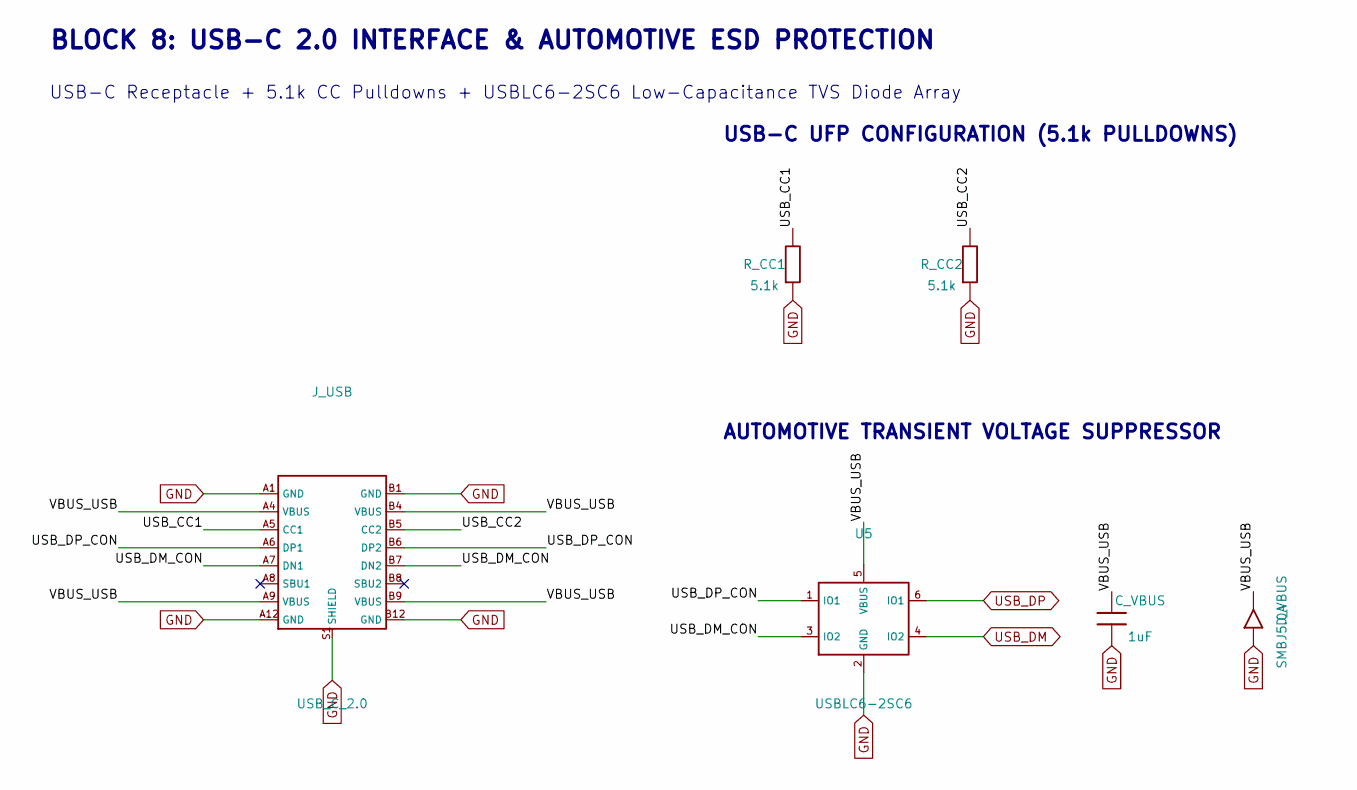
[picture p10: schematic block8_usb_esd.kicad_sch, Block 8: USB-C Interface & ESD Protection]

Parts:
C_VBUS: 1uF; C_0603_1608Metric; MPN CC0603KRX7R8BB105
D_VBUS: SMBJ5.0A; D_SMB; MPN SMBJ5.0A-E3/52
J_USB: USB_C_2.0; USB_C_Receptacle_GCT_USB4085; MPN USB4085-GF-A
R_CC1, R_CC2: 5.1k; R_0603_1608Metric; MPN RC0603FR-075K1L
U5: USBLC6-2SC6; SOT-23-6; MPN USBLC6-2SC6

Connections:
GND: C_VBUS.2, D_VBUS.1 (A), J_USB.A1 (GND), J_USB.A12 (GND), J_USB.B1 (GND), J_USB.B12 (GND), J_USB.S1 (SHIELD), J_USB.SH, R_CC1.2, R_CC2.2, U5.2 (GND); also elsewhere on the board
USB_CC1: J_USB.A5 (CC1), R_CC1.1
USB_CC2: J_USB.B5 (CC2), R_CC2.1
USB_DM: U5.4 (IO2); also elsewhere on the board
USB_DM_CON: J_USB.A7 (DN1), J_USB.B7 (DN2), U5.3 (IO2)
USB_DP: U5.6 (IO1); also elsewhere on the board
USB_DP_CON: J_USB.A6 (DP1), J_USB.B6 (DP2), U5.1 (IO1)
VBUS_USB: C_VBUS.1, D_VBUS.2 (K), J_USB.A4 (VBUS), J_USB.A9 (VBUS), J_USB.B4 (VBUS), J_USB.B9 (VBUS), U5.5 (VBUS)

Notes on the sheet:
USB-C Receptacle + 5.1k CC Pulldowns + USBLC6-2SC6 Low-Capacitance TVS Diode Array
AUTOMOTIVE TRANSIENT VOLTAGE SUPPRESSOR
USB-C UFP CONFIGURATION (5.1k PULLDOWNS)
BLOCK 8: USB-C 2.0 INTERFACE & AUTOMOTIVE ESD PROTECTION

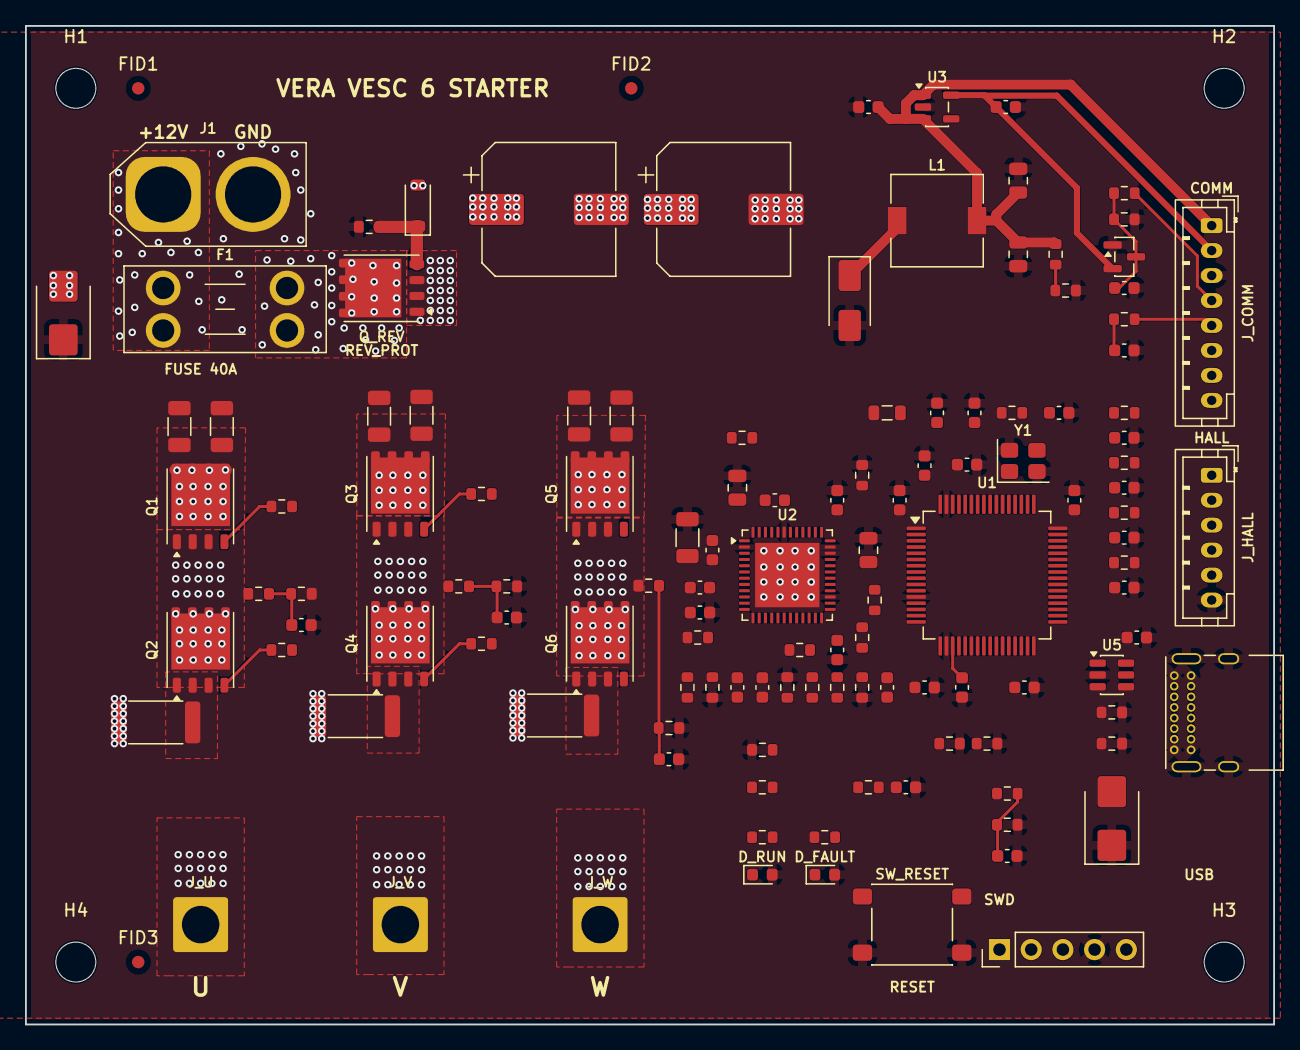
[picture p11: board vera_vesc_starter.kicad_pcb from above]

Board: 4 copper layers, 100.0 x 80.0 mm, 131 parts (0 on the bottom side), 91 nets.

Other parts of the board:
FID1, FID2, FID3: FIDUCIAL; Fiducial_1mm_Mask2mm
H1, H2, H3, H4: M3; MountingHole_3.2mm_M3
