chalmers-vera-team/vera-vesc-starter/(commit log)

2026-11-11 Initial commit: hardware project and VESC firmware submodule
    [block1_power_input.kicad_sch, block2_inverter.kicad_sch, block3_drv8323.kicad_sch, block4_standby_ldo.kicad_sch, block5_stm32f405.kicad_sch, block6_comm_adc.kicad_sch, block7_hall_temp.kicad_sch, block8_usb_esd.kicad_sch]
2026-11-11 Add concise README with project context and 3D PCB render
